Guermz/Spinning_Desicurer/images/spinning_desicurer.png

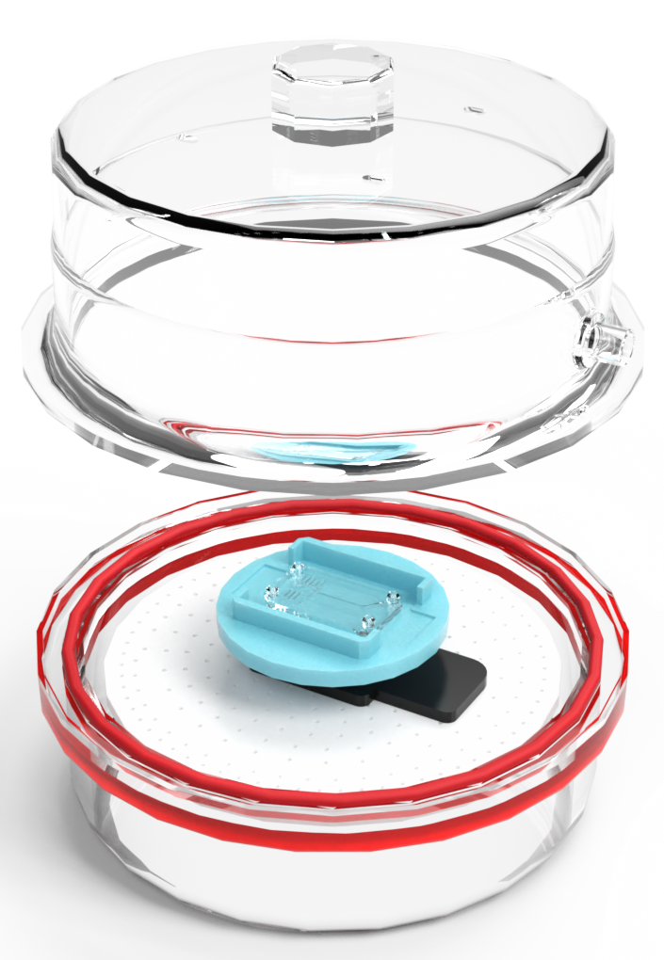
images/spinning_desicurer.png
